owenafk/rack-monitor/images/render_exploded.png

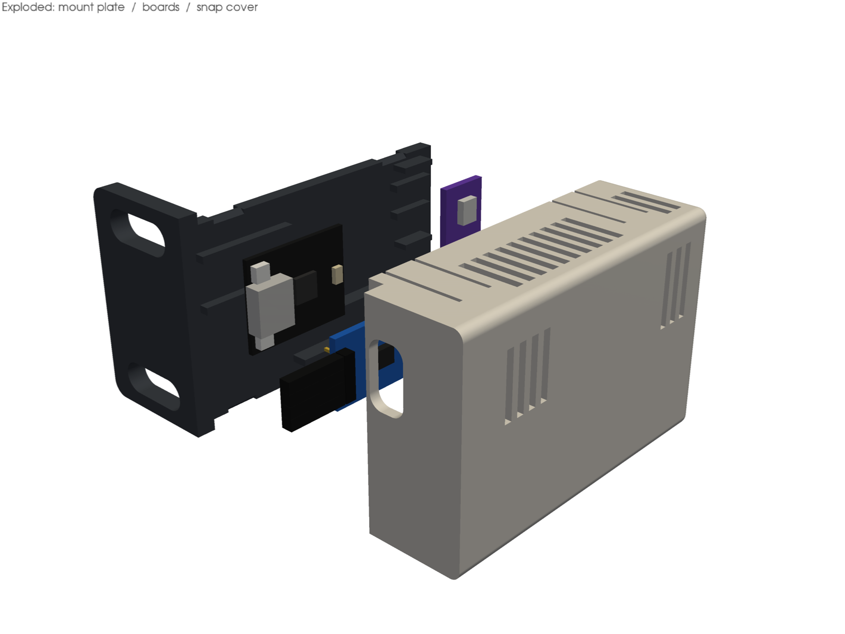
images/render_exploded.png
