owenafk/rack-monitor/cad/cover.step

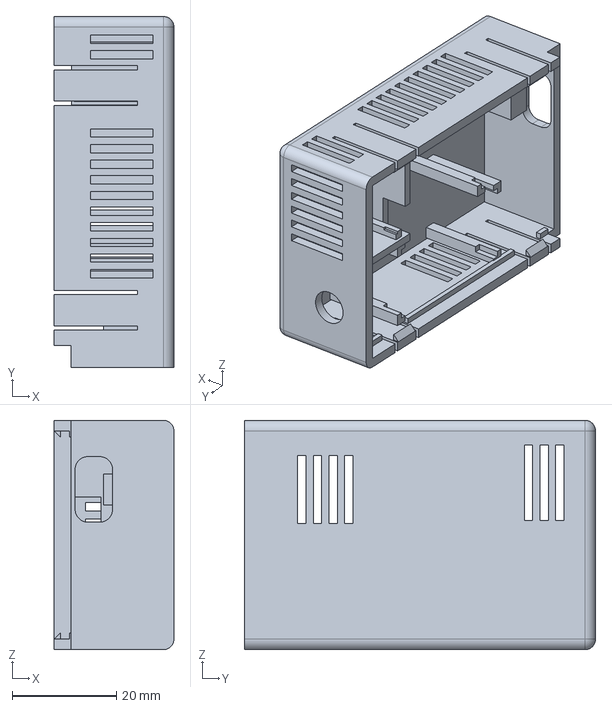
[picture p4: CAD file, 2026-11-10]
cad/cover.step
23.0 x 67.3 x 44.0 mm
