owenafk/rack-monitor/stl/rack_env_mount.stl

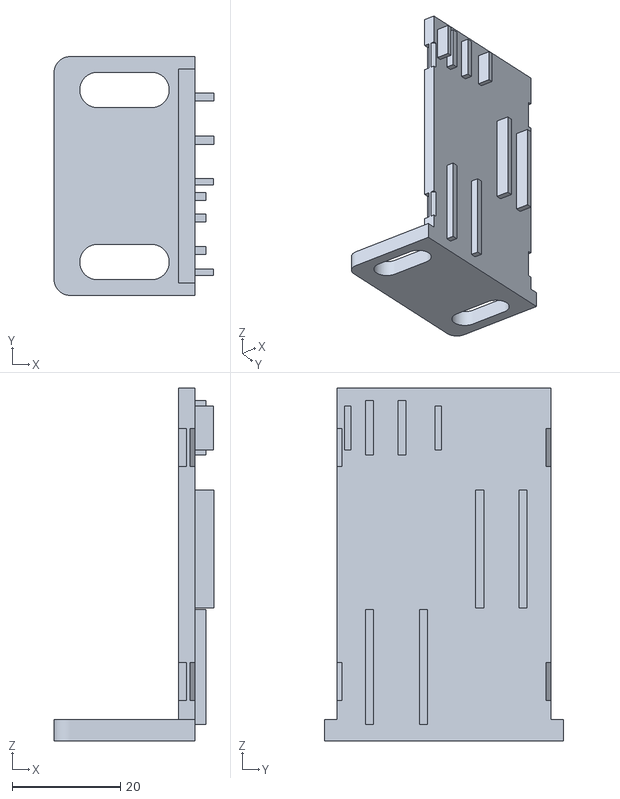
[picture p5: CAD file, 2026-11-10]
stl/rack_env_mount.stl
29.5 x 44.0 x 65.1
