owenafk/rack-monitor/(list of files, cad)

Other CAD files:
cad/mount.step
stl/rack_env_cover.stl
